djnrg/PulseGenerator/PulseGen.brd

## EAGLE design PulseGen.brd (2014-03-03)

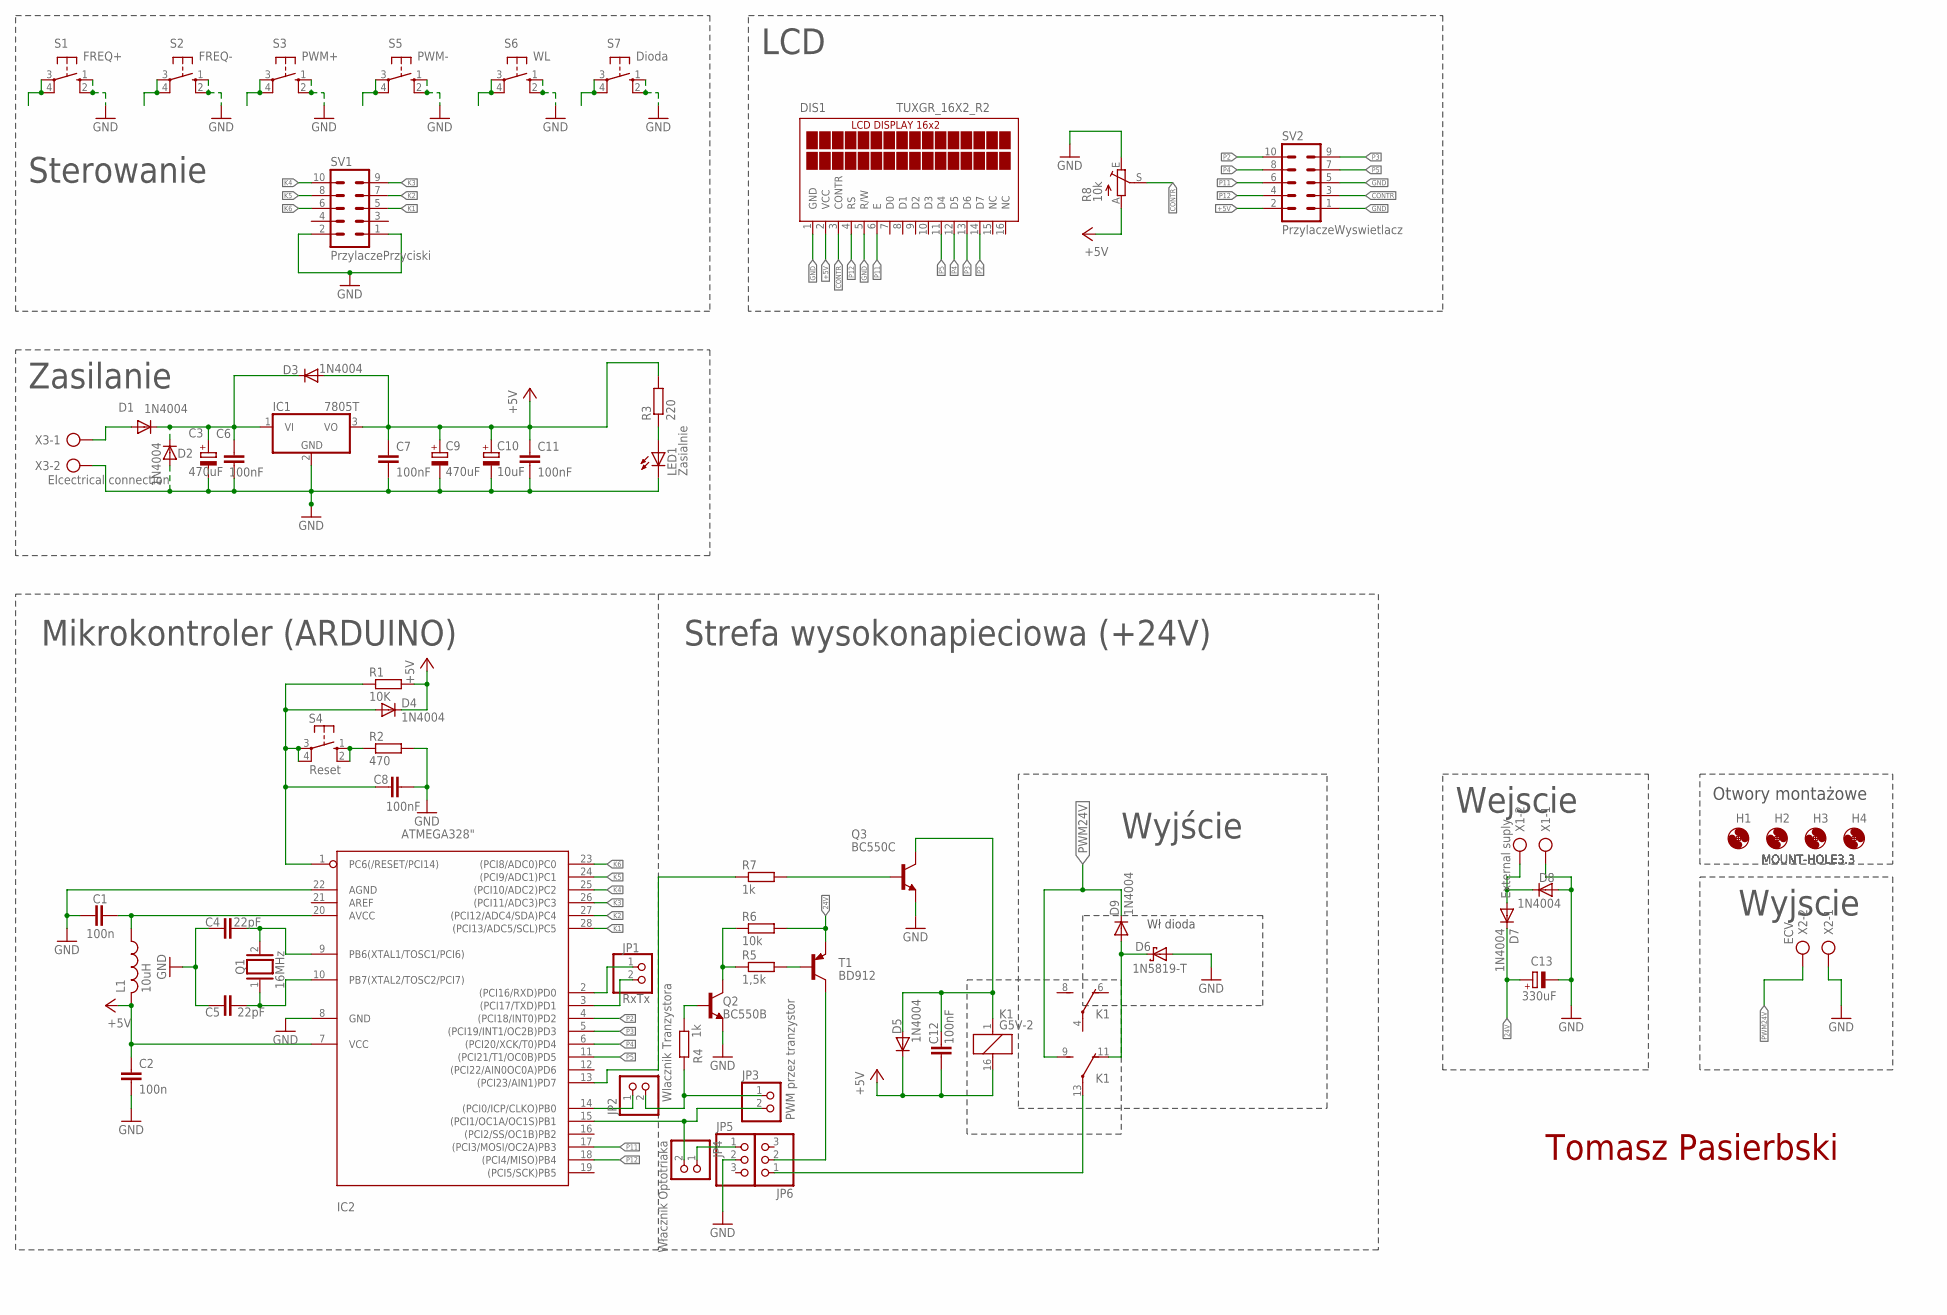
[picture p1: schematic PulseGen.sch]

Parts:
C1, C2: 100n; C025-030X050
C3, C9: 470uF; E3,5-8
C4, C5: 22pF; C025-024X044
C6, C7, C8, C11, C12: 100nF; C025-030X050
C10: 10uF; E5-6
C13: 330uF; E7,5-18
D1, D2, D3, D4, D5, D7, D8, D9: 1N4004; DO41-10
D6: 1N5819-T; DO41-7.6
DIS1: TUXGR_16X2_R2
H1, H2, H3, H4: MOUNT-HOLE3.3; 3,3
IC1: 7805T; TO220H
IC2: ATMEGA328"; ATMEGA328
JP1: RxTx; 1X02
JP2: Wlacznik Tranzystora; 1X02
JP3: PWM przez tranzystor; 1X02
JP4: Włacznik Optotriaka; 1X02
JP5, JP6: PINHD-1X3; 1X03
K1: G5V-2
L1: 10uH; 0204/7
LED1: Zasialnie; LED5MM
Q1: 16MHz; QS
Q2: BC550B; TO92-EBC
Q3: BC550C; TO92-EBC
R1: 10K; 0207/2V
R2: 470; 0207/2V
R3: 220; 0204/7
R4, R7: 1k; 0204/7
R5: 1,5k; 0207/12
R6: 10k; 0204/7
R8: 10k; CA6V
S1: FREQ+; B3F-10XX
S2: FREQ-; B3F-10XX
S3: PWM+; B3F-10XX
S4: Reset; B3F-10XX
S5: PWM-; B3F-10XX
S6: WL; B3F-10XX
S7: Dioda; B3F-10XX
SV1: PrzylaczePrzyciski; ML10
SV2: PrzylaczeWyswietlacz; ML10
T1: BD912; TO220
X1: External suply; AK300/2
X2: ECV; AK300/2
X3: Elcectrical connection; AK300/2

Connections:
24V: C13.+, D7.C, R6.2, T1.3 (E)
+5V: C2.1, C7.1, C9.+, C10.+, C11.1, C12.2, D3.A, D4.C, D5.C, DIS1.2 (VCC), IC1.3 (VO), IC2.7 (VCC), K1.16 (2), L1.2, R1.2, R3.2, R8.A, SV2.2
+24V: D7.A, D8.C, X1.2
CONTR: DIS1.3 (CONTR), R8.S, SV2.3
GND: C1.2, C2.2, C3.-, C4.1, C5.1, C6.2, C7.2, C8.2, C9.-, C10.-, C11.2, C13.-, D2.A, D6.A, D8.A, DIS1.1 (GND), DIS1.5 (R/W), IC1.2 (GND), IC2.8 (GND), IC2.22 (AGND), JP5.2, LED1.K (C), Q2.E, Q3.E, R2.2, R8.E, S1.1 (S), S1.2 (S1), S2.1 (S), S2.2 (S1), S3.1 (S), S3.2 (S1), S5.1 (S), S5.2 (S1), S6.1 (S), S6.2 (S1), S7.1 (S), S7.2 (S1), SV1.1, SV1.2, SV2.1, SV2.5, X1.1, X2.1, X3.2
K1: IC2.28 ((PCI13/ADC5/SCL)PC5), SV1.5
K2: IC2.27 ((PCI12/ADC4/SDA)PC4), SV1.7
K3: IC2.26 ((PCI11/ADC3)PC3), SV1.9
K4: IC2.25 ((PCI10/ADC2)PC2), SV1.10
K5: IC2.24 ((PCI9/ADC1)PC1), SV1.8
K6: IC2.23 ((PCI8/ADC0)PC0), SV1.6
unnamed: C5.2, IC2.10 (PB7(XTAL2/TOSC2/PCI7)), Q1.1
unnamed: C3.+, C6.1, D1.C, D2.C, D3.C, IC1.1 (VI)
unnamed: C4.2, IC2.9 (PB6(XTAL1/TOSC1/PCI6)), Q1.2
unnamed: D1.A, X3.1
unnamed: C12.1, D5.A, K1.1, Q3.C
unnamed: C1.1, IC2.20 (AVCC), L1.1
unnamed: Q3.B, R7.2
unnamed: JP2.2, JP3.1, R4.1
unnamed: Q2.C, R5.1, R6.1
unnamed: R2.1, S4.1 (S), S4.2 (S1)
unnamed: C8.1, D4.A, IC2.1 (PC6(/RESET/PCI14)), R1.1, S4.3, S4.4 (P1)
unnamed: JP6.1, K1.13
unnamed: IC2.13 ((PCI23/AIN1)PD7), R7.1
unnamed: Q2.B, R4.2
unnamed: R5.2, T1.1 (B)
unnamed: JP6.2, T1.2 (C)
unnamed: IC2.14 ((PCI0/ICP/CLKO)PB0), JP2.1
unnamed: LED1.A, R3.1
unnamed: IC2.15 ((PCI1/OC1A/OC1S)PB1), JP3.2, JP4.2
unnamed: S1.3, S1.4 (P1)
unnamed: S2.3, S2.4 (P1)
unnamed: S3.3, S3.4 (P1)
unnamed: S5.3, S5.4 (P1)
unnamed: S6.3, S6.4 (P1)
unnamed: S7.3, S7.4 (P1)
unnamed: IC2.3 ((PCI17/TXD)PD1), JP1.2
unnamed: IC2.2 ((PCI16/RXD)PD0), JP1.1
unnamed: JP4.1, JP5.1
unnamed: D6.C, D9.A, K1.11 (O)
P2: DIS1.14 (D7), IC2.4 ((PCI18/INT0)PD2), SV2.10
P3: DIS1.13 (D6), IC2.5 ((PCI19/INT1/OC2B)PD3), SV2.9
P4: DIS1.12 (D5), IC2.6 ((PCI20/XCK/T0)PD4), SV2.8
P5: DIS1.11 (D4), IC2.11 ((PCI21/T1/OC0B)PD5), SV2.7
P11: DIS1.6 (E), IC2.17 ((PCI3/MOSI/OC2A)PB3), SV2.6
P12: DIS1.4 (RS), IC2.18 ((PCI4/MISO)PB4), SV2.4
PWM24V: D9.C, K1.9 (S), X2.2

Notes on the sheet:
Zasilanie
LCD
Wejscie
Wyjscie
Sterowanie
Wł dioda
Wyjście
Mikrokontroler (ARDUINO)
Strefa wysokonapieciowa (+24V)
Otwory montażowe
Tomasz Pasierbski

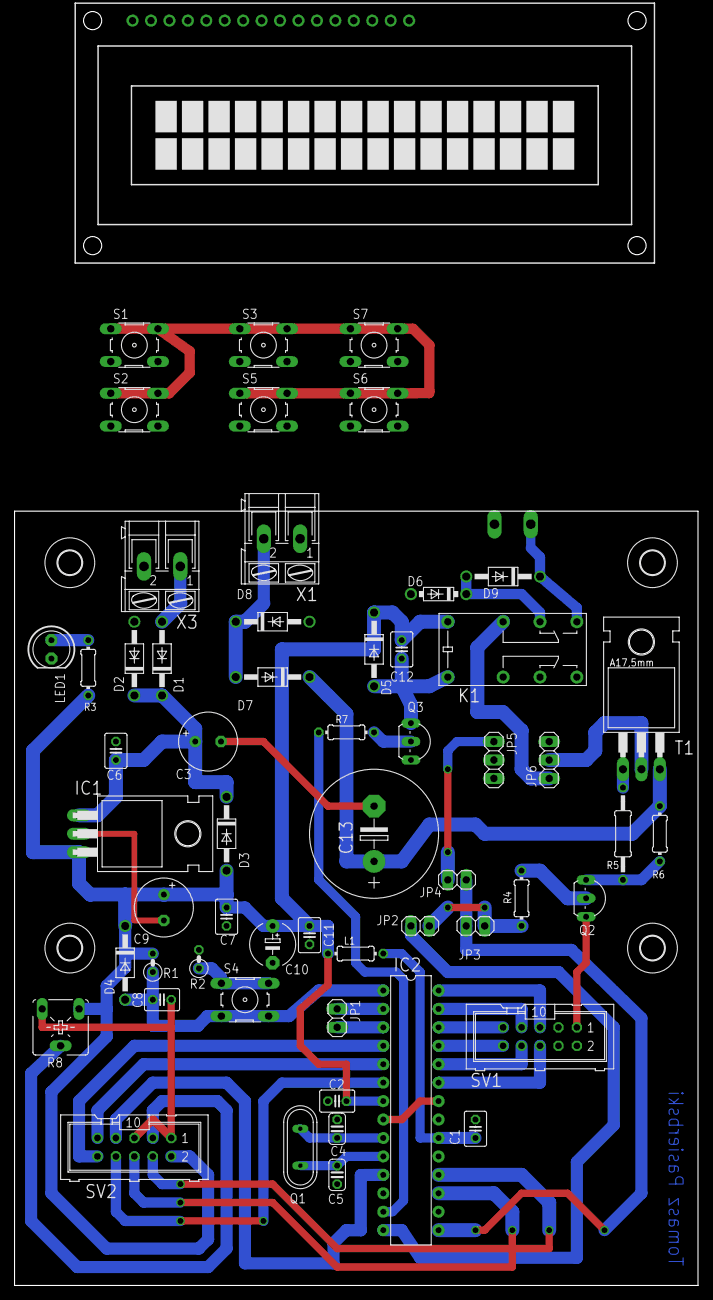
[picture p2: board PulseGen.brd from above]

Board: 2 copper layers, 94.2 x 106.7 mm, 64 parts (1 on the bottom side), 47 nets.

Other parts of the board:
DRILEGEND: DRILEGEND
U$1: A4P-LOC
